bobbycar-graz/Bobbycar-FOC-hardware/README.md

# Bobbycar-FOC-hardware
Our own dual BLDC Motorcontroller

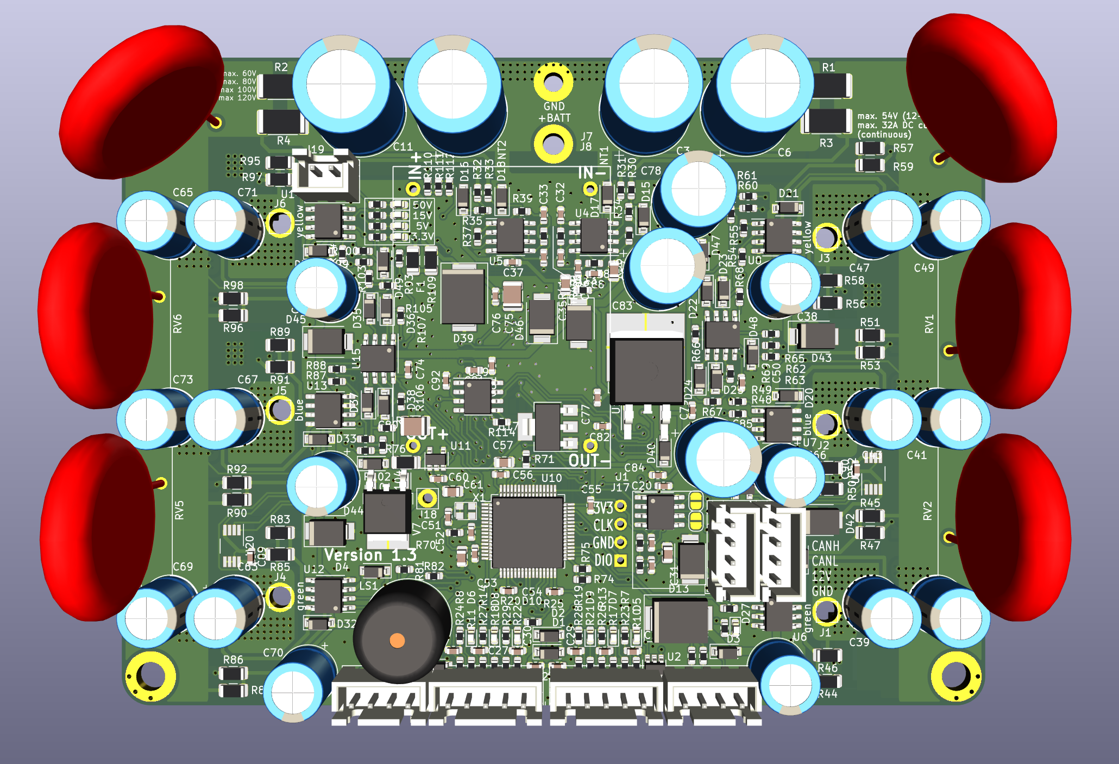
[picture p1: images/3d.png]
