bobbycar-graz/Bobbycar-FOC-hardware/(threads)

Thread 2 (2022-01-07):

Is this PCB fully compatible?

abrarakram19, 2022-01-07:
Is this board design final version compatible with latest firmware version? Or there are any changes? And what is usage of CAN interface implemented in hardware?
And have anyone assembled this PCB? Is it working perfectly or have some issues?
I want to make some modifications on this pcb layout, is there any suggestions for me to address any noticed problem on this layout?
And many thanks for everyone who made this hardware and firmware available as open source.

Thread 5 (2022-04-08):

Clamping diodes on phase current opamp inputs

mickdermack, 2022-04-08:
In the LTspice model I received from Peter, there is an additional clamping diode D4 on the + input of the opamp, which is not present in the KiCAD schematic.

@dschiedsch: Should it be added to the schematic, or is there a reason it was omitted?

Thread 7 (2022-08-09):

Implement 4 motor controller

CommanderRedYT, 2022-08-09:
New pcb layout with lay-down mounted JST, MR30 and XT90.
- http://www.china-amass.com/product/contain/15J45228797MUA28
- http://www.china-amass.com/product/contain/p154529i6gv89Dm1

Single pcb, 2 stm / gd
Single TWAI connector for boardcomputer
Power distribution with exposed copper to solder wire to.
Flat design (lay components down), optimize for minimal height

CommanderRedYT, 2022-12-20:
Will not happen

Closed 2022-12-20.
