bobbycar-graz/Bobbycar-FOC-hardware/pdf/Bobbycontroller.pdf

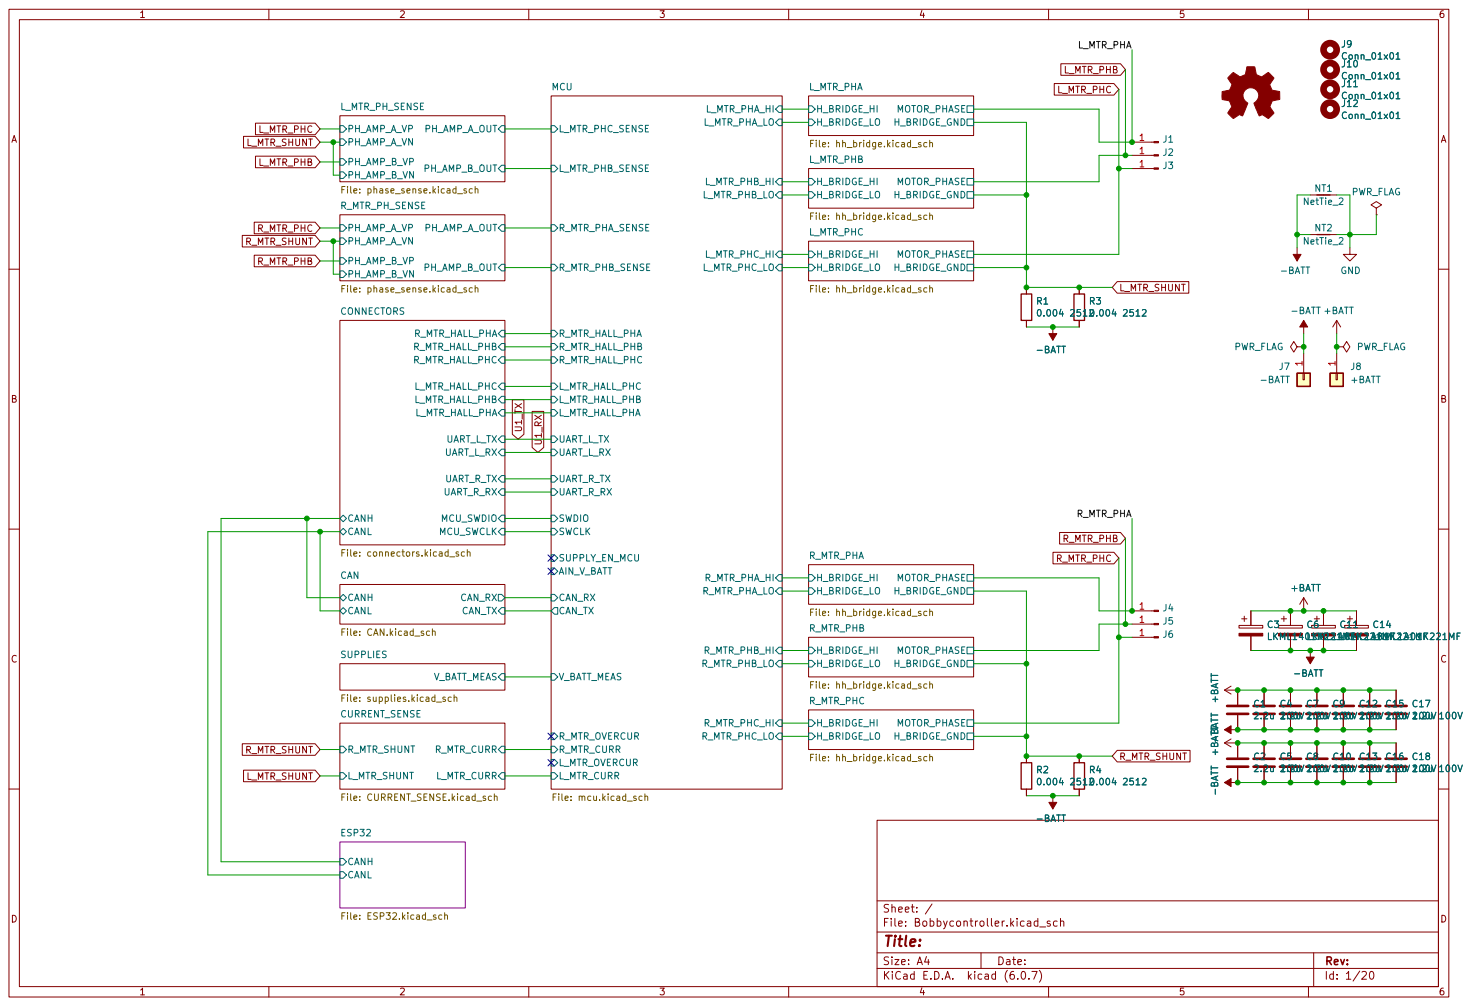
[picture p2: page 1]

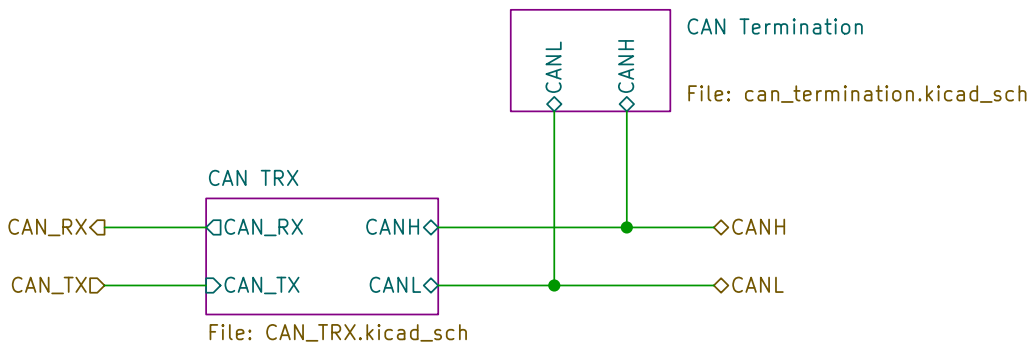
[picture p3: page 2]

CAN Termination File: can_termination.kicad_sch CANH

File: CAN.kicad_sch Sheet: /CAN/
Id: 2/20 Title:

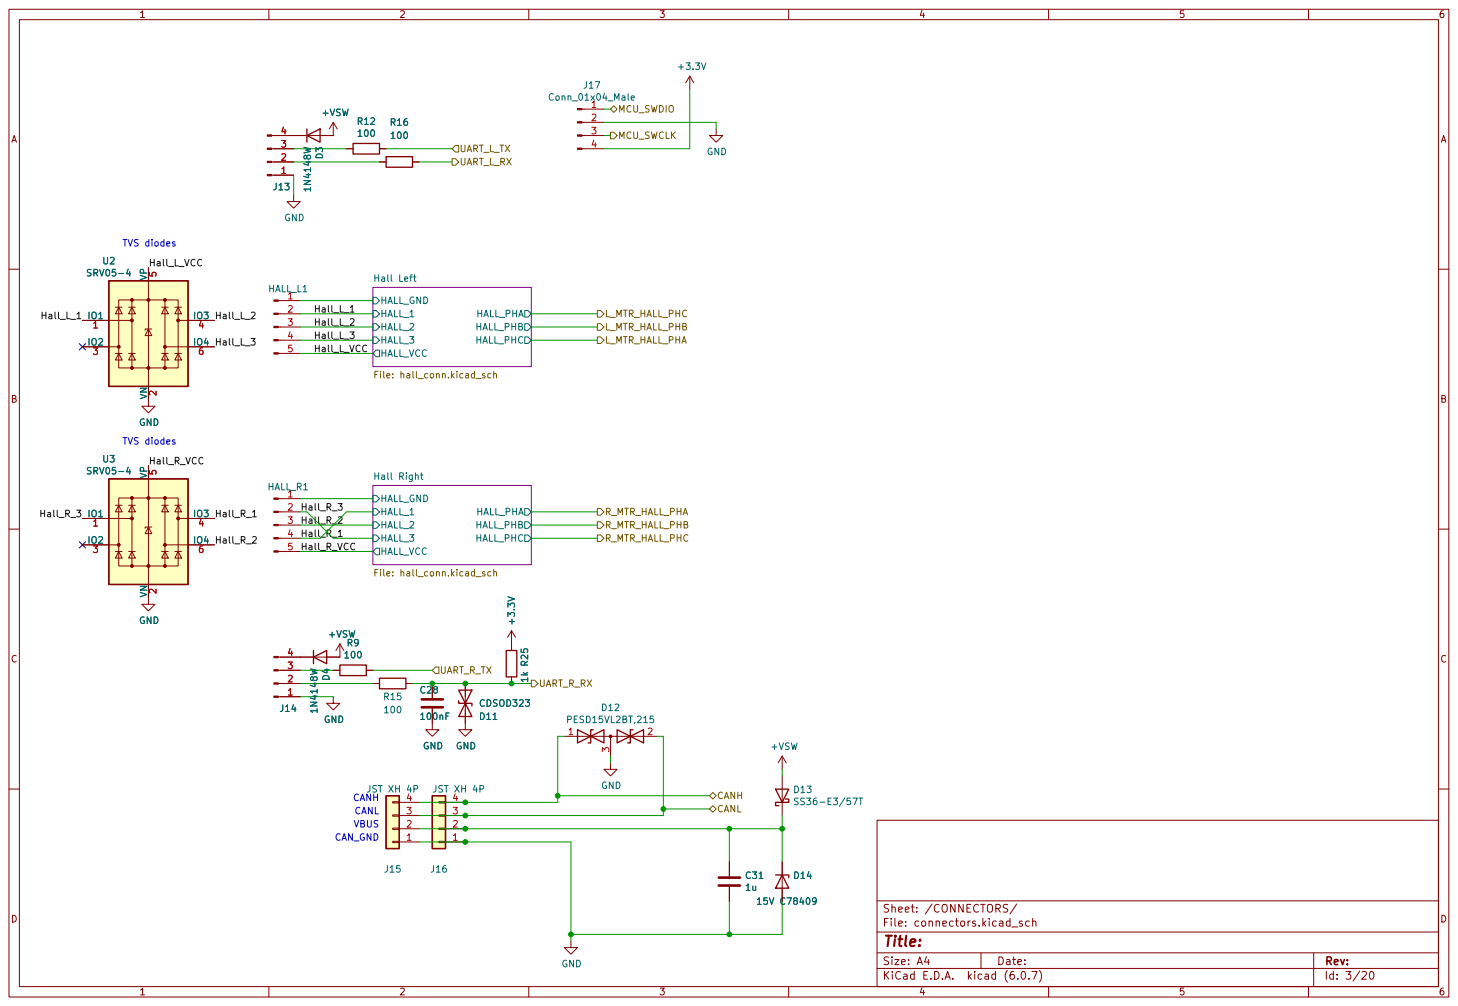
[picture p4: page 3]

File: connectors.kicad_sch Sheet: /CONNECTORS/ HALL_2 HALL_GND
HALL_1 HALL_3 HALL_VCC

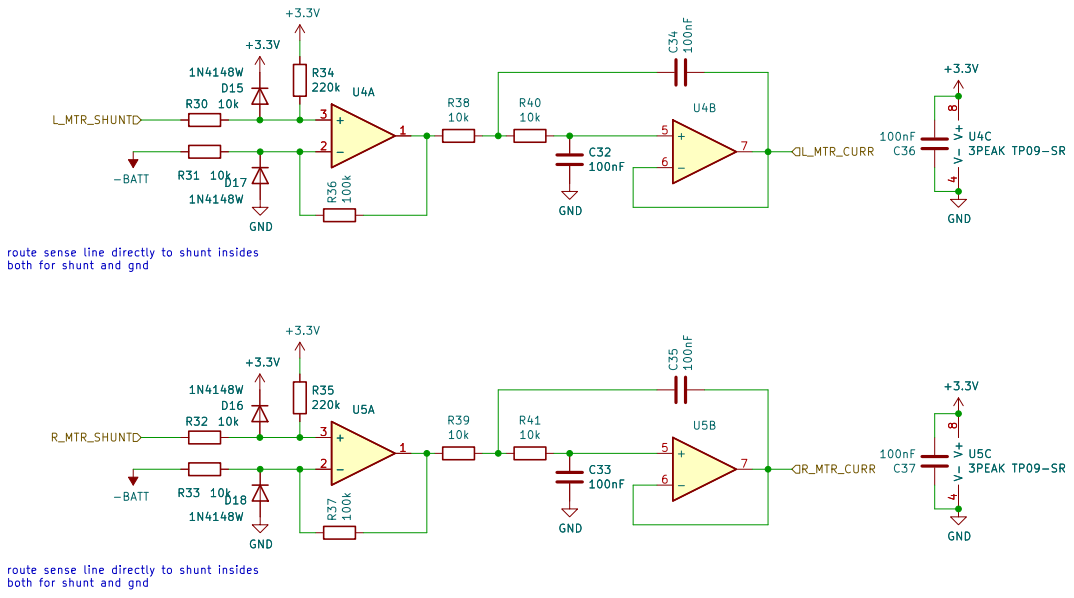
[picture p5: page 4]

route sense line directly to shunt insides

both for shunt and gnd

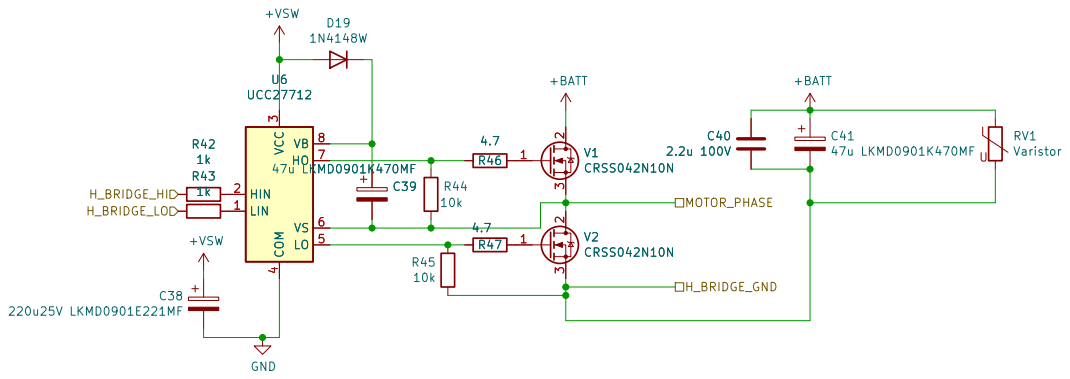
[picture p6: page 5]

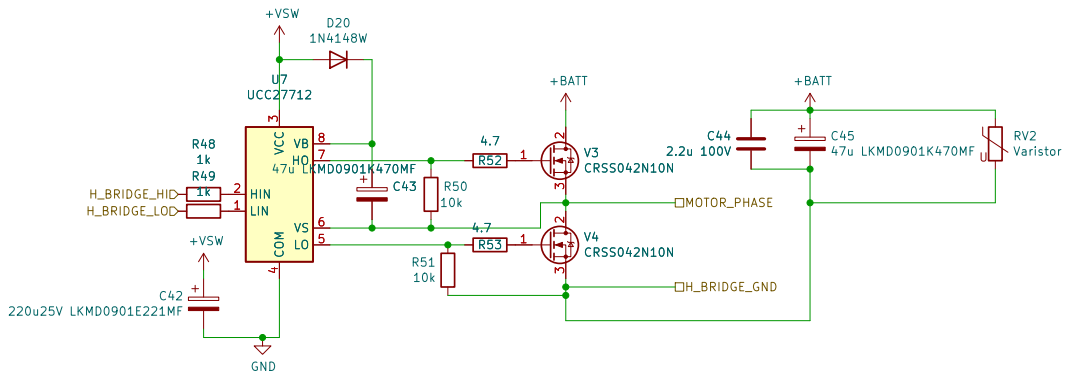
[picture p7: page 6]

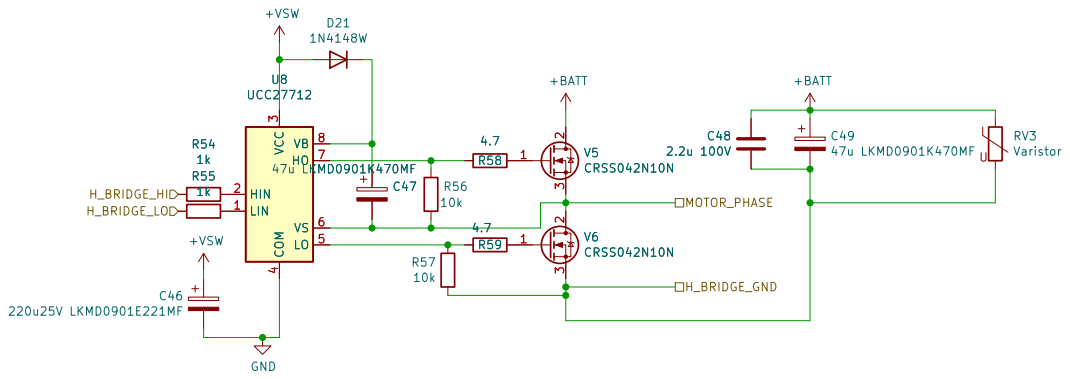
[picture p8: page 7]

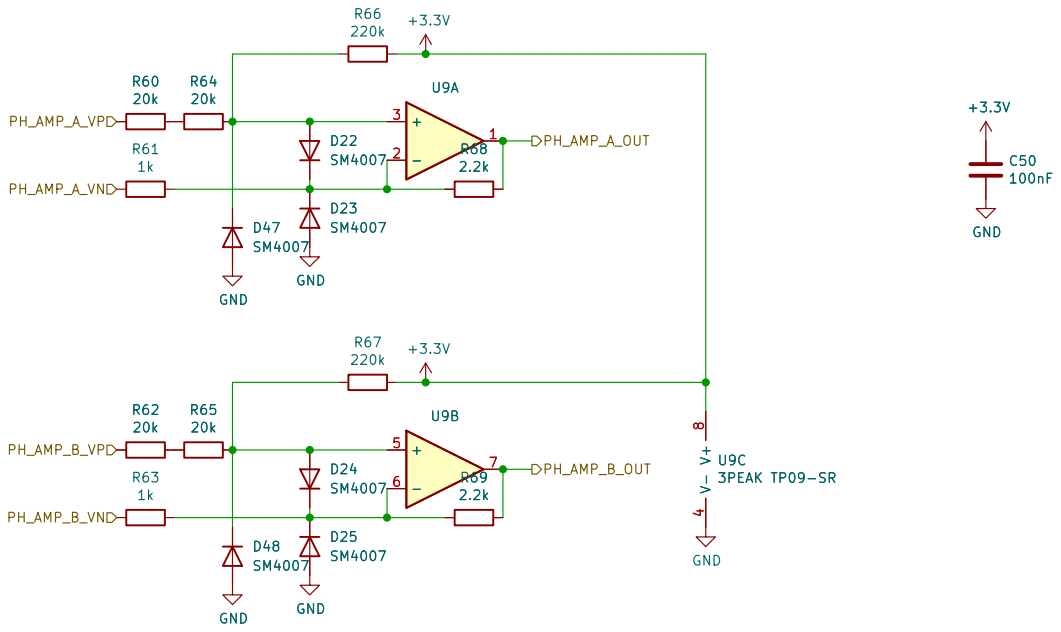
[picture p9: page 8]

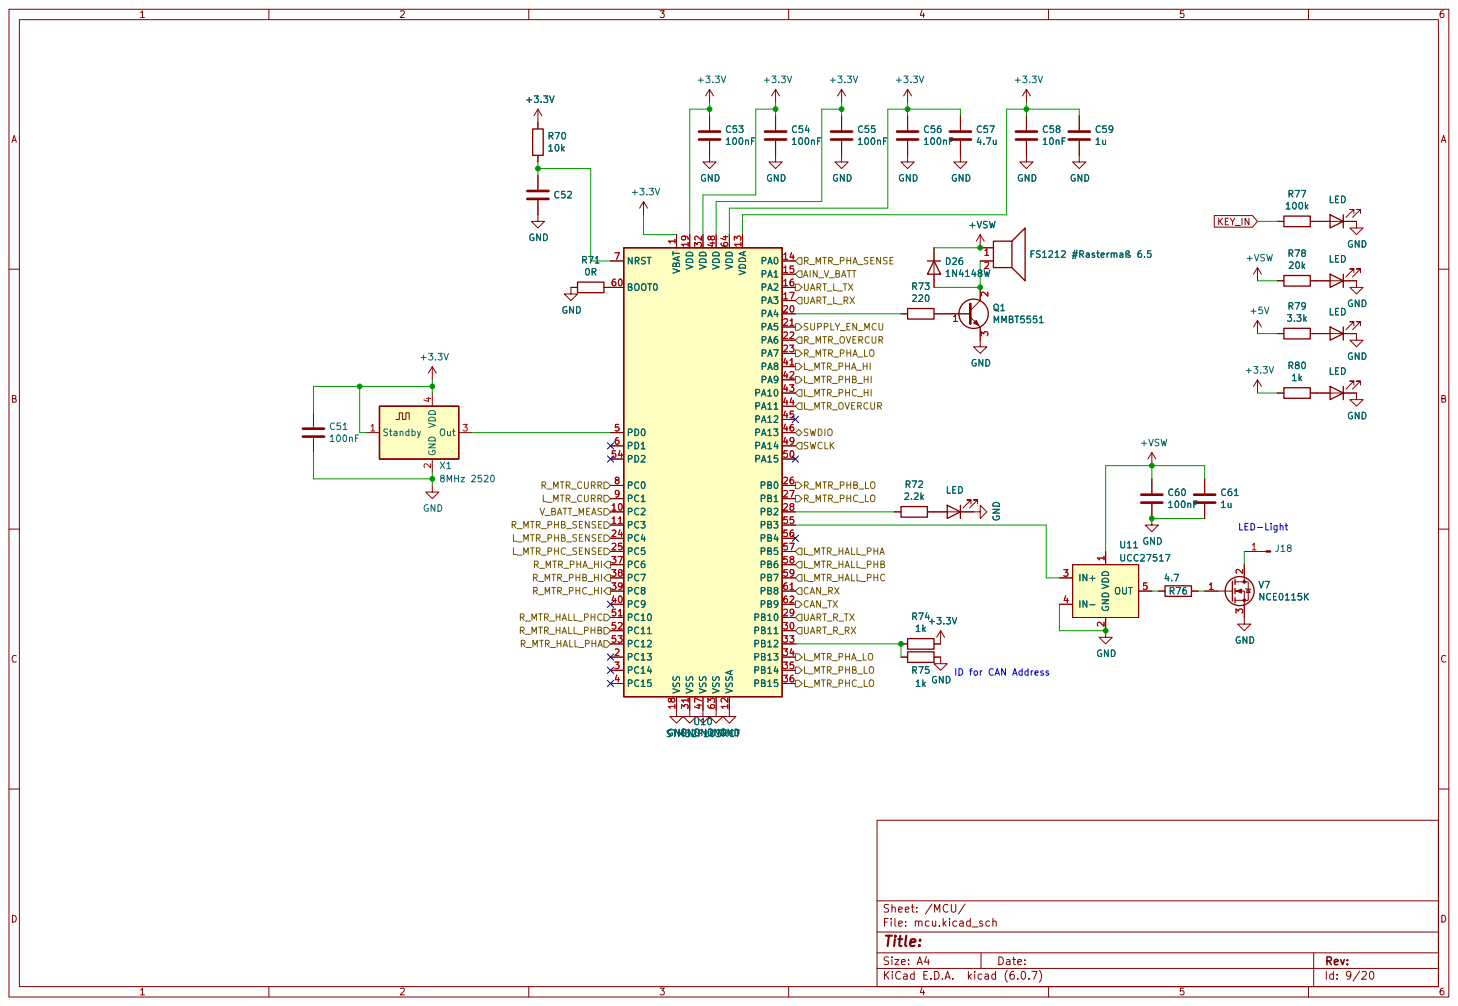
[picture p10: page 9]

1 PC2 10 PC3 11 VSSA 12 VDDA 13 PA0 14 PA1 15 PA2 16 PA3 17 VSS 18 VDD 19 PC13 2 PA4 20 PA5 21 PA6 22 PA7 23 PC4 24 PC5 25 PB0 26 PB1 27 PB2 28 PB10 29 PC14 3 PB11 30 VSS 31 VDD 32 PB12 33 PB13 34 PB14 35 PB15 36 PC6 37 PC7 38 PC8 39 PC15 4 PC9 40 PA8 41 PA9 42 PA10 43 PA11 44 PA12 45 PA13 46 VSS 47 VDD 48 PA14 49 PD0 5 PA15 50 PC10 51 PC11 52 PC12 53 PD2 54 PB3 55 PB4 56 PB5 57 PB6 58 PB7 59 PD1 6 BOOT0 60 PB8 61 PB9 62 VSS 63 VDD 64 NRST 7 PC0 8 PC1 9 C54

ID for CAN Address GND GND

1 PC2 10 PC3 11 VSSA 12 VDDA 13 PA0 14 PA1 15 PA2 16 PA3 17 VSS 18 VDD 19 PC13 2 PA4 20 PA5 21 PA6 22 PA7 23 PC4 24 PC5 25 PB0 26 PB1 27 PB2 28 PB10 29 PC14 3 PB11 30 VSS 31 VDD 32 PB12 33 PB13 34 PB14 35 PB15 36 PC6 37 PC7 38 PC8 39 PC15 4 PC9 40 PA8 41 PA9 42 PA10 43 PA11 44 PA12 45 PA13 46 VSS 47 VDD 48 PA14 49 PD0 5 PA15 50 PC10 51 PC11 52 PC12 53 PD2 54 PB3 55 PB4 56 PB5 57 PB6 58 PB7 59 PD1 6 BOOT0 60 PB8 61 PB9 62 VSS 63 VDD 64 NRST 7 PC0 8 PC1 9 U10 GND STM32F103RCT GNDGNDGNDGND

File: mcu.kicad_sch Sheet: /MCU/
Id: 9/20 Title:

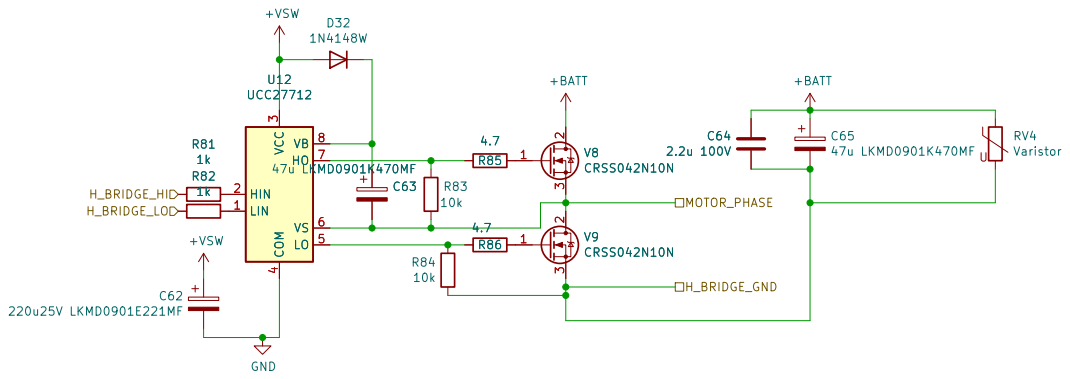
[picture p11: page 10]

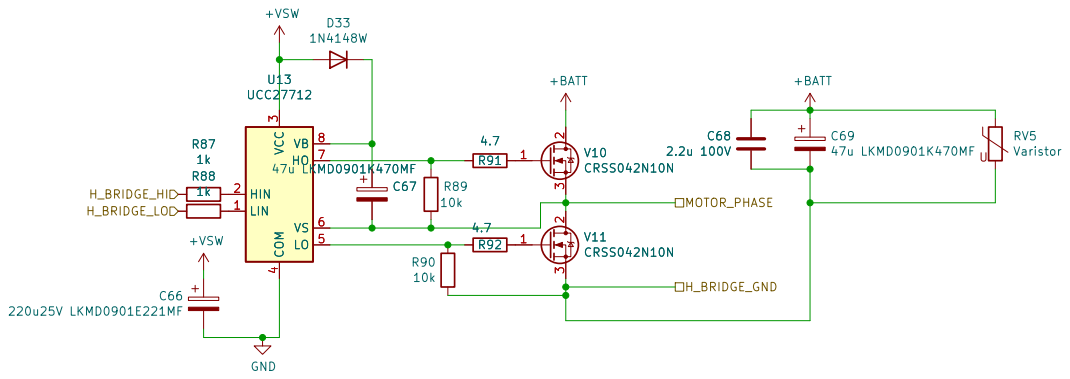
[picture p12: page 11]

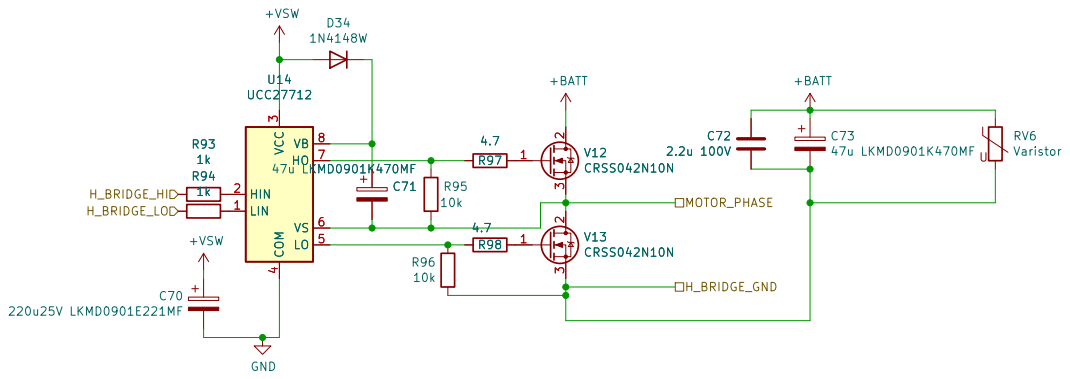
[picture p13: page 12]

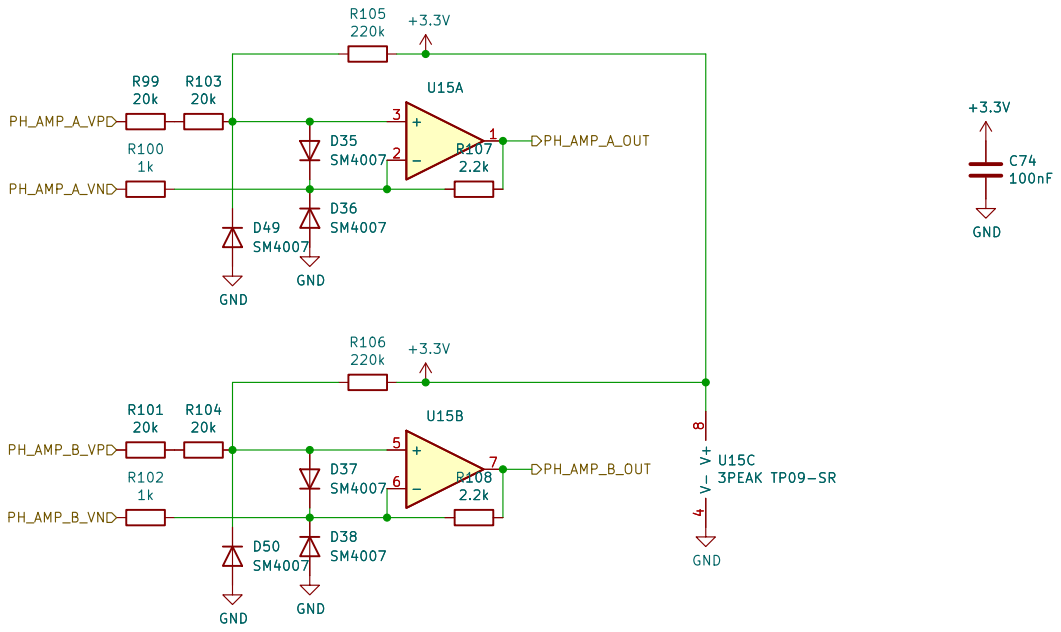
[picture p14: page 13]

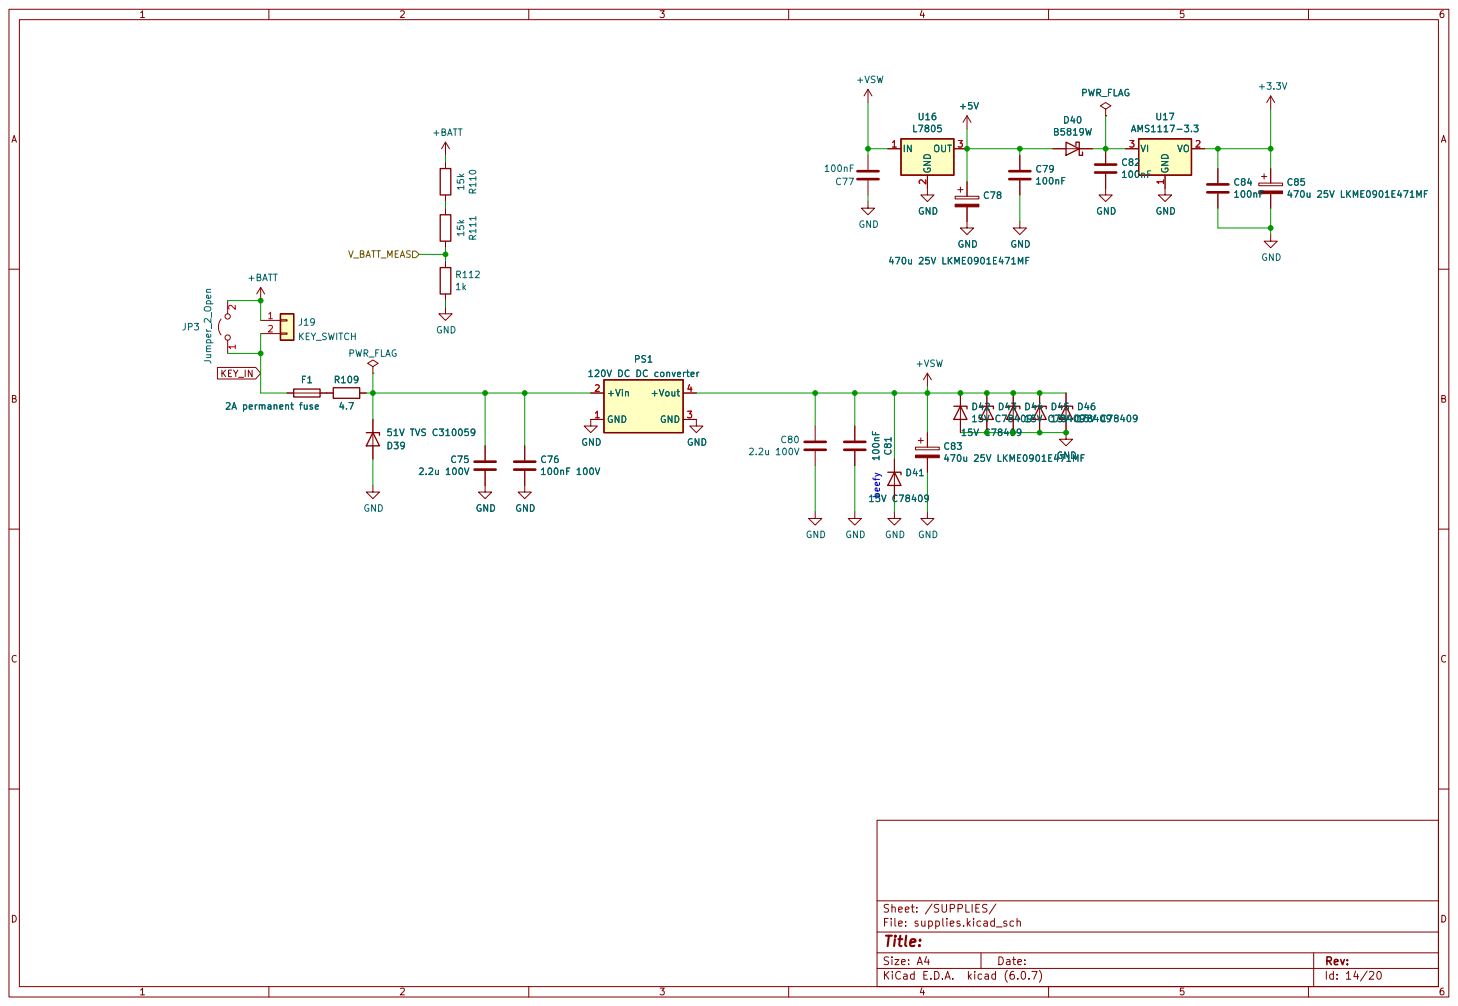
[picture p15: page 14]

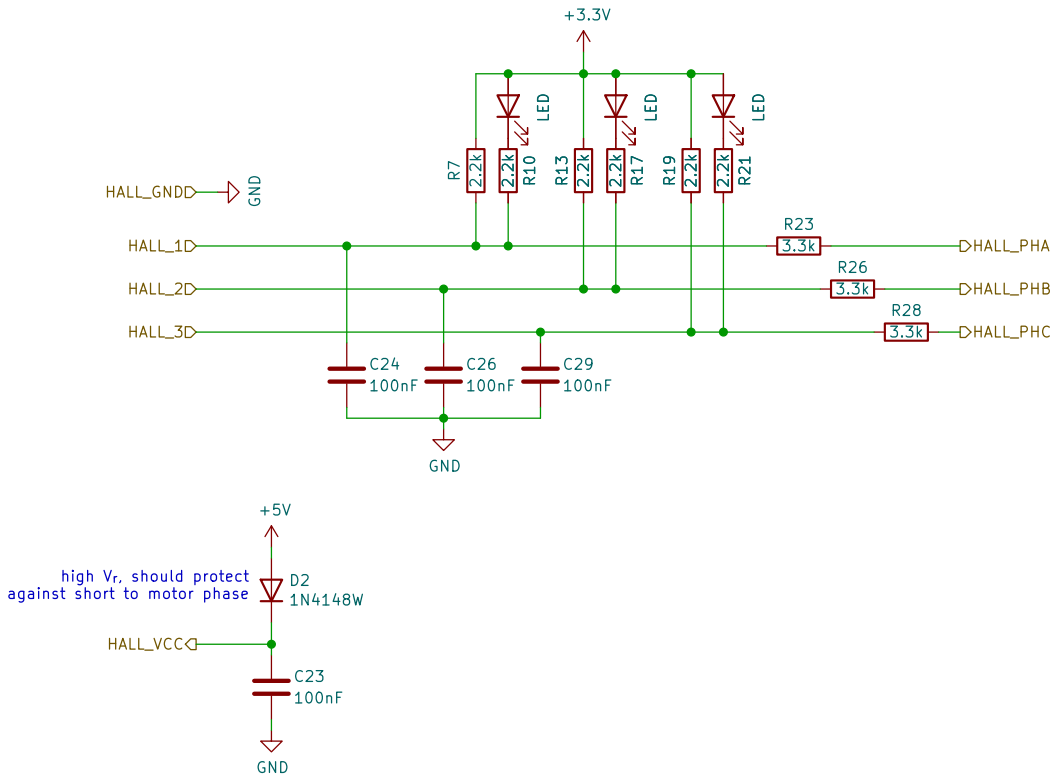
[picture p16: page 15]

File: hall_conn.kicad_sch Sheet: /CONNECTORS/Hall Left/ C24

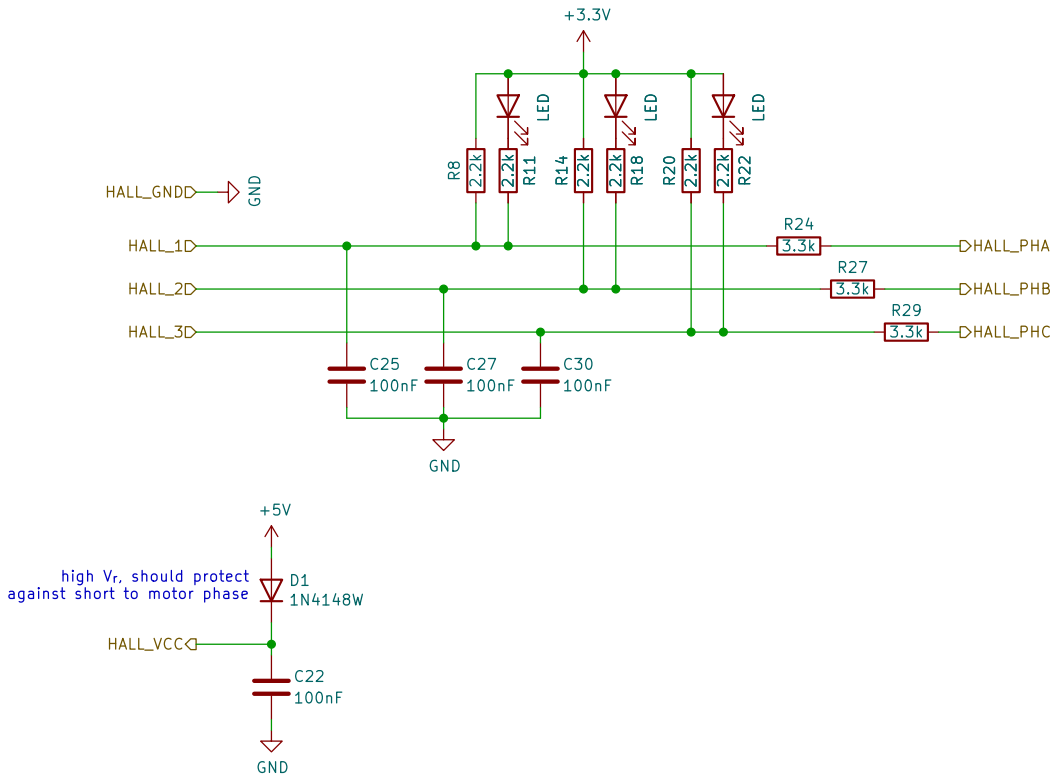
[picture p17: page 16]

Sheet: /CONNECTORS/Hall Right/ C25

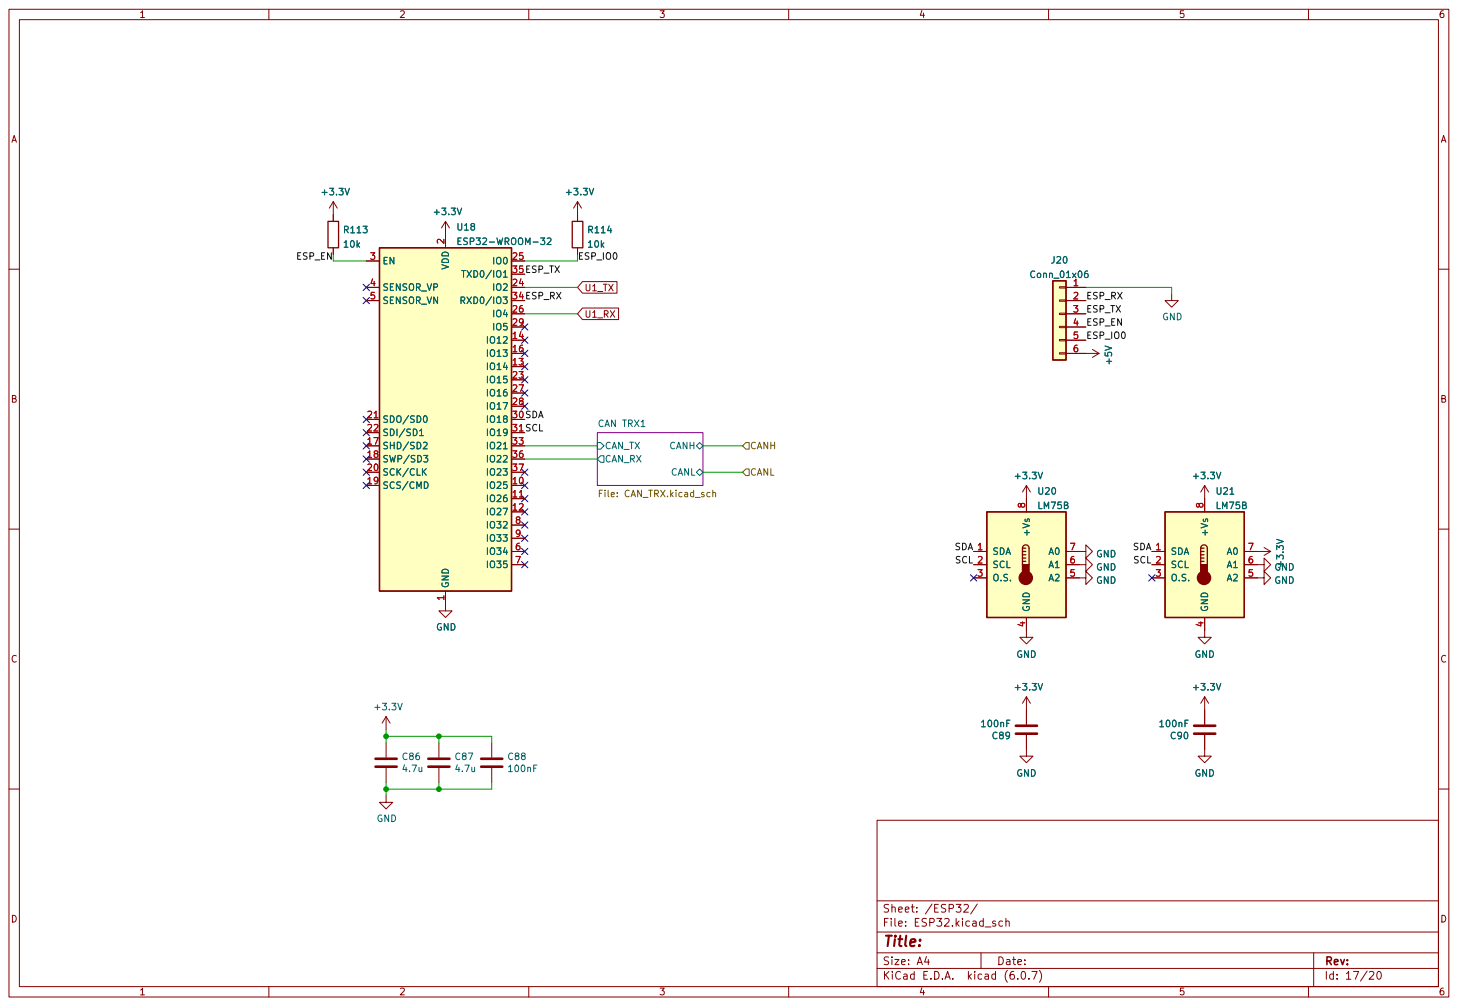
[picture p18: page 17]

2 SCK/CLK 20 SDO/SD0 21 SDI/SD1 22
J20 Conn_01x06 GND

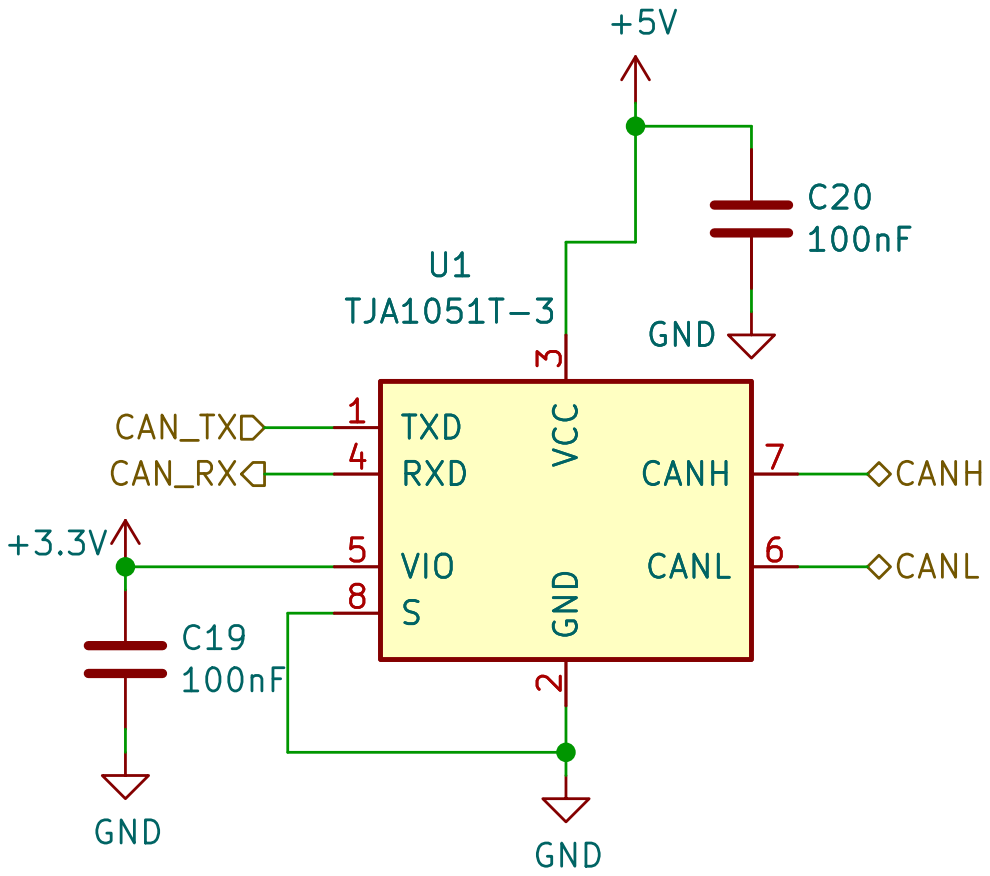
[picture p19: page 18]

3 RXD 4 VIO 5 CANL 6 CANH 7 S

File: CAN_TRX.kicad_sch Sheet: /CAN/CAN TRX/ GND

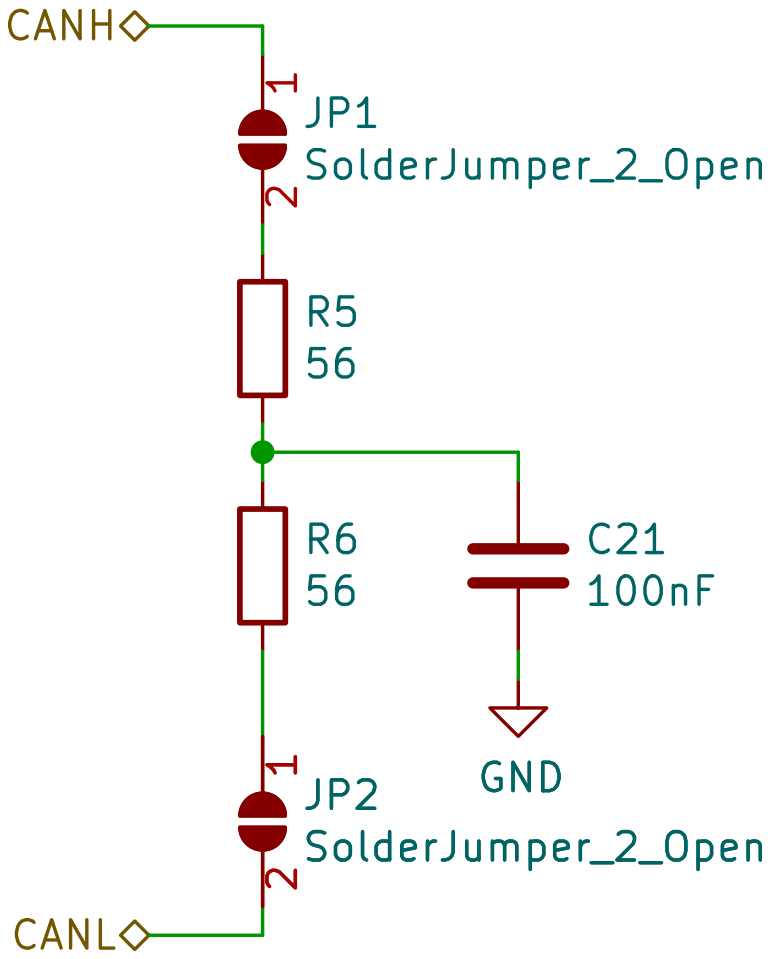
[picture p20: page 19]

File: can_termination.kicad_sch Sheet: /CAN/CAN Termination/
Id: 19/20 Title:

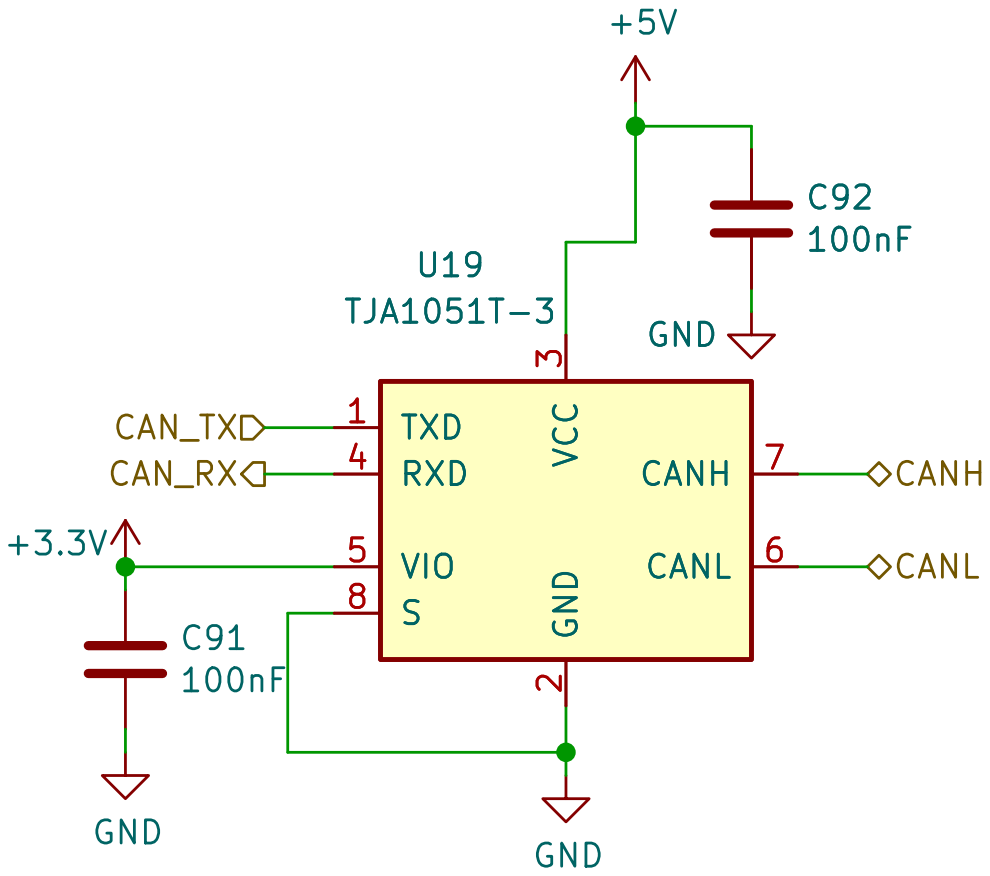
[picture p21: page 20]

3 RXD 4 VIO 5 CANL 6 CANH 7 S

File: CAN_TRX.kicad_sch Sheet: /ESP32/CAN TRX1/ GND
