bobbycar-graz/Bobbycar-FOC-hardware/Bobbycontroller.kicad_pcb

## KiCad design Bobbycontroller.kicad_pcb (continued)

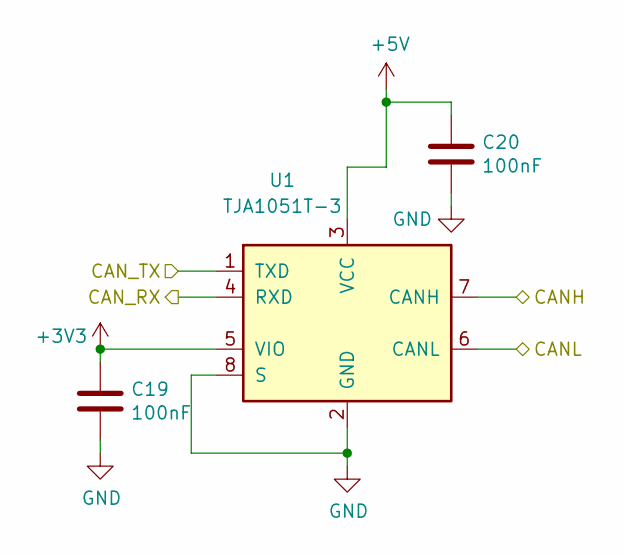
[picture p31: schematic CAN_TRX.kicad_sch]

Parts:
C19, C20: 100nF; C_0603_1608Metric; LCSC C14663
U1: TJA1051T-3; SOIC-8_3.9x4.9mm_P1.27mm; LCSC C38695

Connections:
+3V3: C19.1, U1.5 (VIO); also elsewhere on the board
+5V: C20.1, U1.3 (VCC); also elsewhere on the board
/CAN/CANH: U1.7 (CANH); also elsewhere on the board
/CAN/CANL: U1.6 (CANL); also elsewhere on the board
/CAN/CAN_RX: U1.4 (RXD); also elsewhere on the board
/CAN/CAN_TX: U1.1 (TXD); also elsewhere on the board
GND: C19.2, C20.2, U1.2 (GND), U1.8 (S); also elsewhere on the board

Parts of its further copies:
C91, C92: 100nF; C_0603_1608Metric; LCSC C14663
U19: TJA1051T-3; SOIC-8_3.9x4.9mm_P1.27mm; LCSC C38695

Connections of its further copies:
+3V3: C91.1, U19.5 (VIO); also elsewhere on the board
+5V: C92.1, U19.3 (VCC); also elsewhere on the board
/CAN/CANH: U19.7 (CANH); also elsewhere on the board
/CAN/CANL: U19.6 (CANL); also elsewhere on the board
/ESP32/CAN TRX1/CAN_RX: U19.4 (RXD); also elsewhere on the board
/ESP32/CAN TRX1/CAN_TX: U19.1 (TXD); also elsewhere on the board
GND: C91.2, C92.2, U19.2 (GND), U19.8 (S); also elsewhere on the board

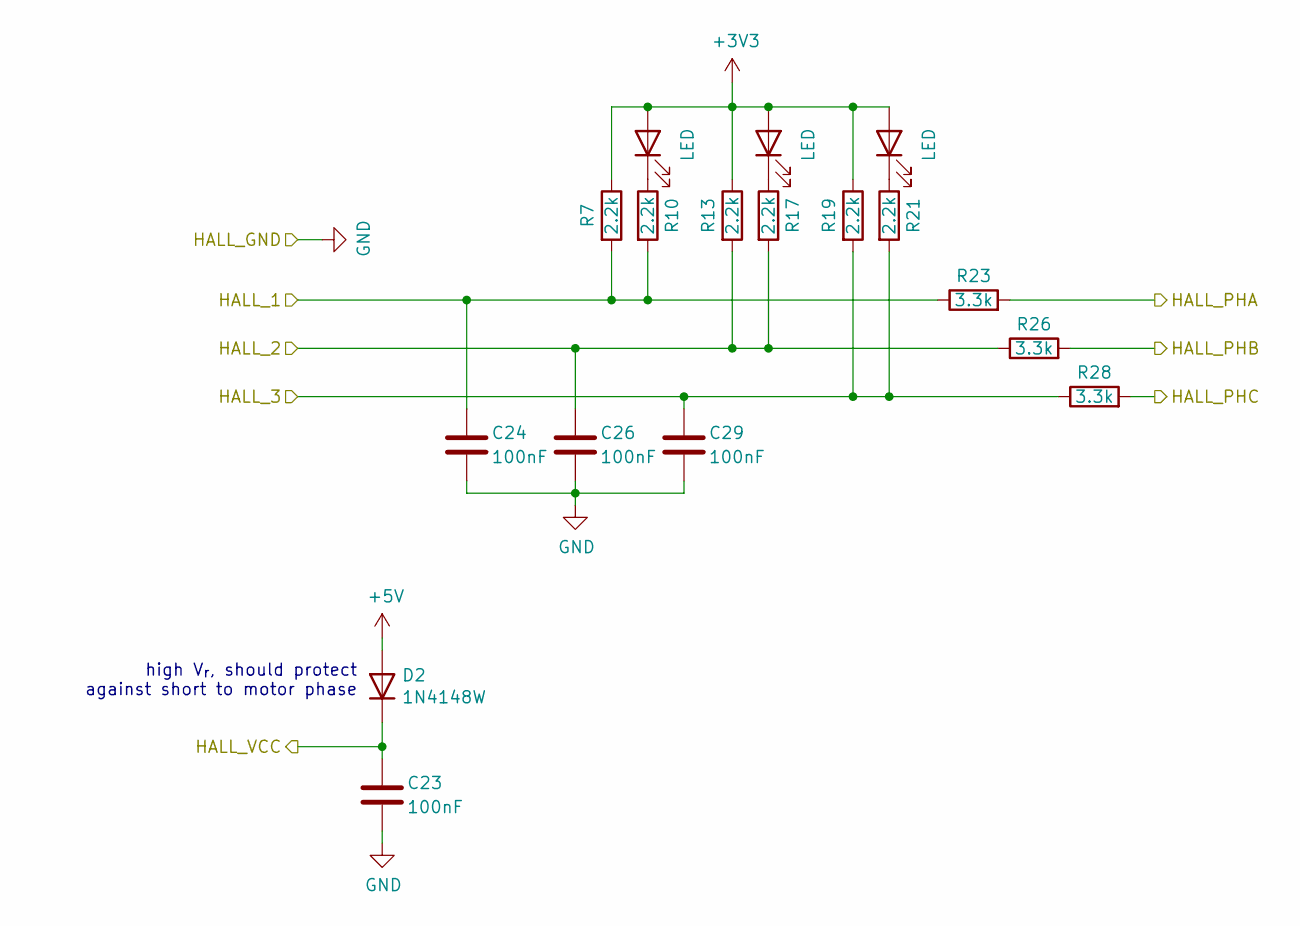
[picture p32: schematic hall_conn.kicad_sch]

Parts:
C23, C24, C26, C29: 100nF; C_0603_1608Metric; LCSC C14663
D2: 1N4148W; D_SOD-123; LCSC C81598
D5, D7, D9: LED; LED_0603_1608Metric; LCSC C2290
R7, R10, R13, R17, R19, R21: 2.2k; R_0603_1608Metric; LCSC C4190
R23, R26, R28: 3.3k; R_0603_1608Metric; LCSC C22978

Connections:
+3V3: D5.2 (A), D7.2 (A), D9.2 (A), R7.1, R13.1, R19.1; also elsewhere on the board
+5V: D2.2 (A); also elsewhere on the board
/CONNECTORS/Hall_L_1: C24.1, R7.2, R10.2, R23.1; also elsewhere on the board
/CONNECTORS/Hall_L_2: C26.1, R13.2, R17.2, R26.1; also elsewhere on the board
/CONNECTORS/Hall_L_3: C29.1, R19.2, R21.2, R28.1; also elsewhere on the board
/CONNECTORS/Hall_L_VCC: C23.1, D2.1 (K); also elsewhere on the board
/CONNECTORS/L_MTR_HALL_PHA: R28.2; also elsewhere on the board
/CONNECTORS/L_MTR_HALL_PHB: R26.2; also elsewhere on the board
/CONNECTORS/L_MTR_HALL_PHC: R23.2; also elsewhere on the board
GND: C23.2, C24.2, C26.2, C29.2; also elsewhere on the board
unnamed: D5.1 (K), R10.1
unnamed: D7.1 (K), R17.1
unnamed: D9.1 (K), R21.1

Parts of its further copies:
C22, C25, C27, C30: 100nF; C_0603_1608Metric; LCSC C14663
D1: 1N4148W; D_SOD-123; LCSC C81598
D6, D8, D10: LED; LED_0603_1608Metric; LCSC C2290
R8, R11, R14, R18, R20, R22: 2.2k; R_0603_1608Metric; LCSC C4190
R24, R27, R29: 3.3k; R_0603_1608Metric; LCSC C22978

Connections of its further copies:
+3V3: D6.2 (A), D8.2 (A), D10.2 (A), R8.1, R14.1, R20.1; also elsewhere on the board
+5V: D1.2 (A); also elsewhere on the board
/CONNECTORS/Hall_R_1: C25.1, R8.2, R11.2, R24.1; also elsewhere on the board
/CONNECTORS/Hall_R_2: C27.1, R14.2, R18.2, R27.1; also elsewhere on the board
/CONNECTORS/Hall_R_3: C30.1, R20.2, R22.2, R29.1; also elsewhere on the board
/CONNECTORS/Hall_R_VCC: C22.1, D1.1 (K); also elsewhere on the board
/CONNECTORS/R_MTR_HALL_PHA: R24.2; also elsewhere on the board
/CONNECTORS/R_MTR_HALL_PHB: R27.2; also elsewhere on the board
/CONNECTORS/R_MTR_HALL_PHC: R29.2; also elsewhere on the board
GND: C22.2, C25.2, C27.2, C30.2; also elsewhere on the board
unnamed: D6.1 (K), R11.1
unnamed: D8.1 (K), R18.1
unnamed: D10.1 (K), R22.1

Notes on the sheet:
high V_{r}, should protect against short to motor phase

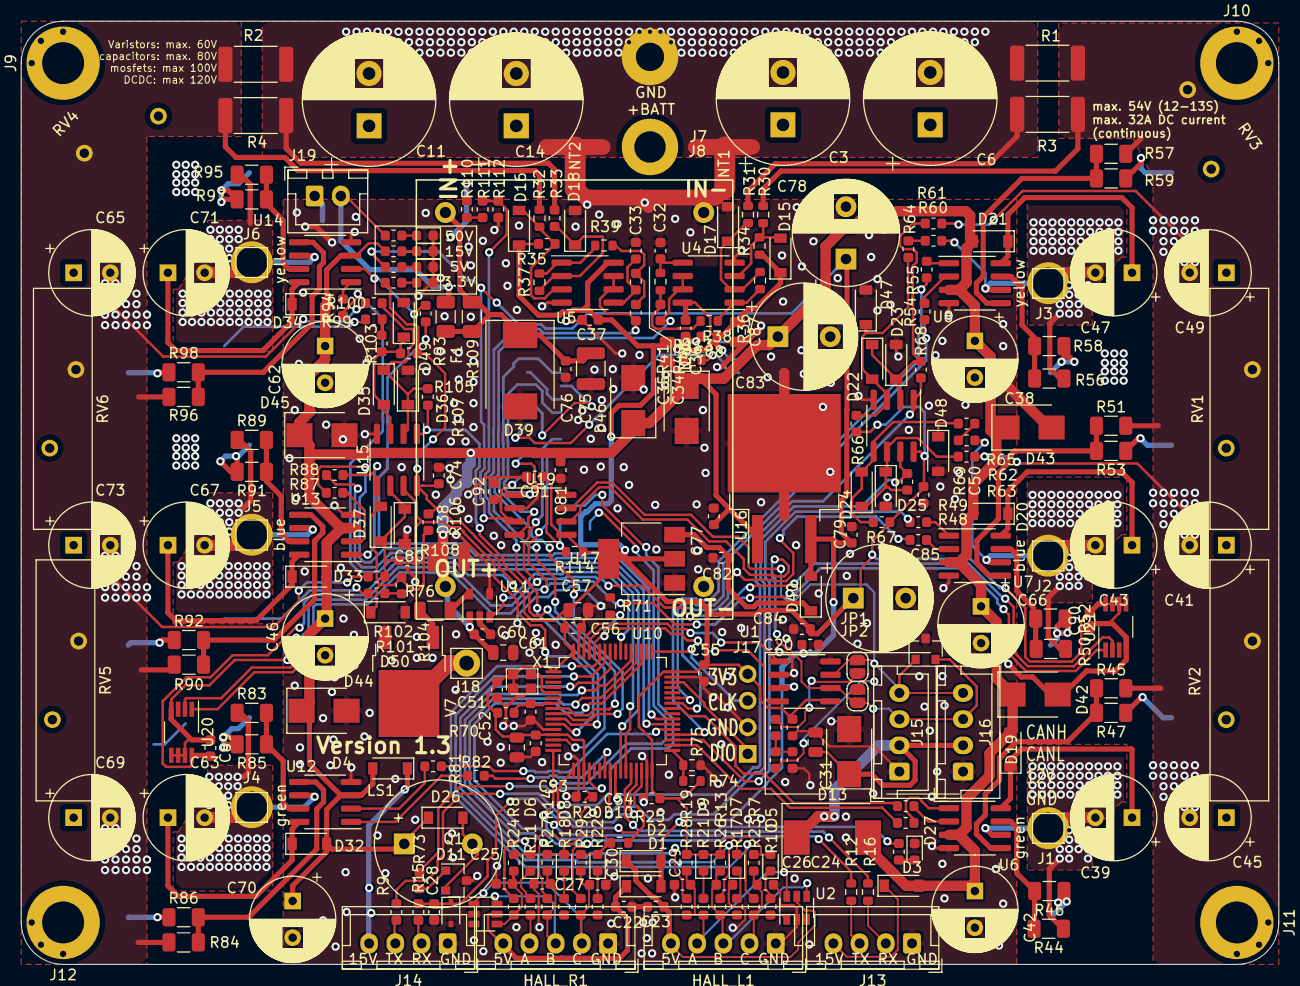
[picture p33: board Bobbycontroller.kicad_pcb from above]

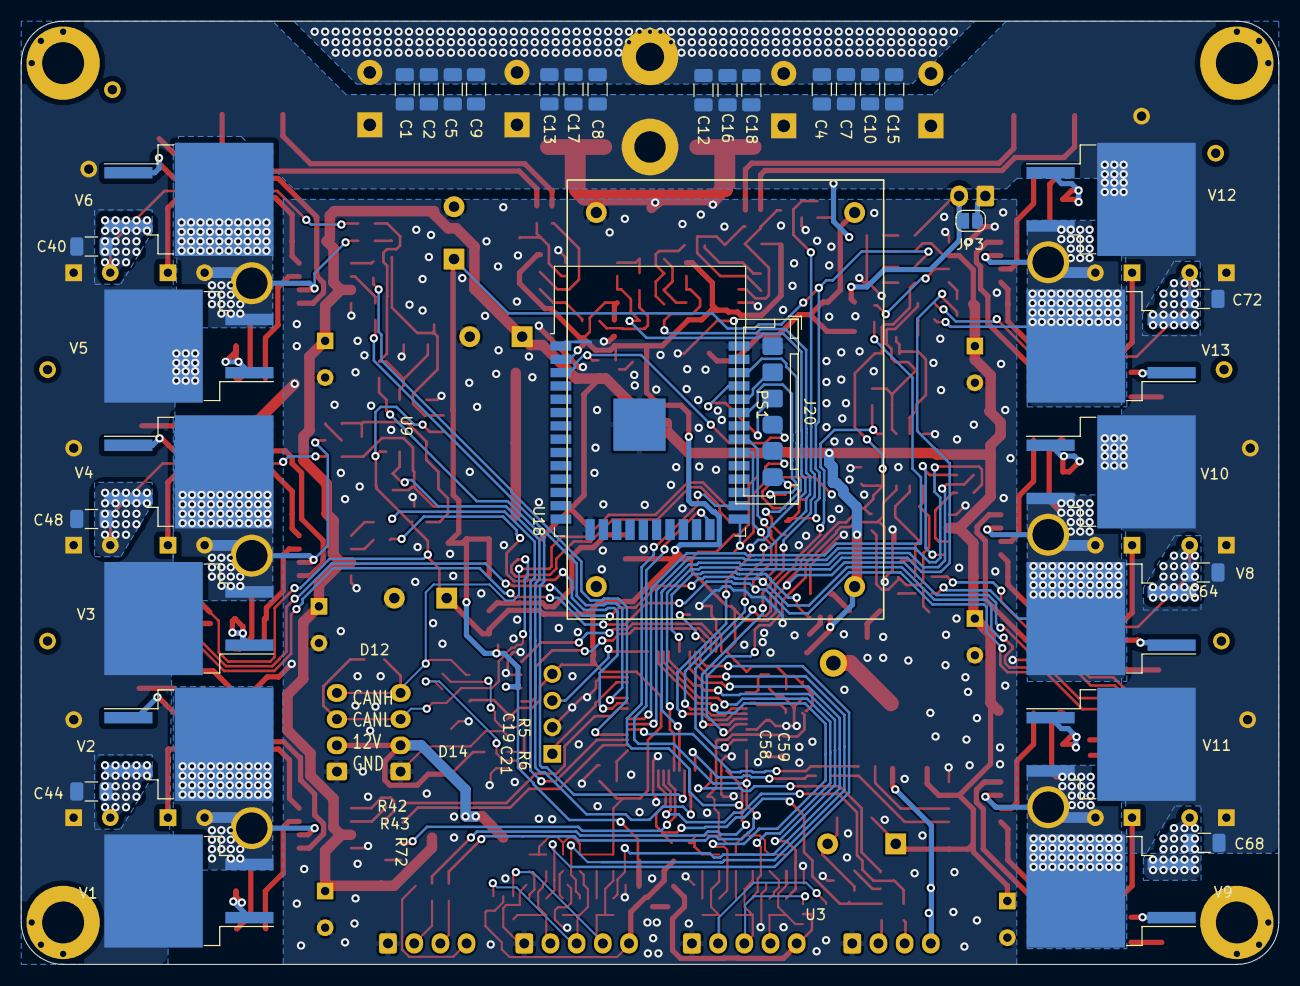
[picture p34: board Bobbycontroller.kicad_pcb from below]

Board: 2 copper layers, 120.0 x 90.0 mm, 328 parts (36 on the bottom side), 166 nets.
