bobbycar-graz/Bobbycar-FOC-hardware/(commit log)

2020-09-27 Fix MCU NRST connection
    [mcu.sch]
2020-09-27 fix some errors
    [Bobbycontroller.sch, CURRENT_SENSE.sch, mcu.sch]
2020-09-27 fix all ERC errors
    [Bobbycontroller.sch, connectors.sch]
2020-09-27 Add CAN transceiver
    [Bobbycontroller.sch, CAN.sch, CURRENT_SENSE.sch, connectors.sch, hh_bridge.sch, mcu.sch, phase_sense.sch, supplies.sch]
2020-09-27 Do MCU bypassing according to datasheet; annotate
    [CAN.sch, connectors.sch, mcu.sch]
2020-09-27 Add +3.3V reverse current protection diode; add +3.3V on debug header
    [connectors.sch, supplies.sch]
2020-09-28 Add missing FET driver connection
    [hh_bridge.sch]
2020-09-28 initial board layout
    [Bobbycontroller.kicad_pcb]
2020-09-28 Remove PWR_FLAG from UART header
    [connectors.sch]
2020-09-28 Add TVS diode, fuse to 15 V supply
    [CURRENT_SENSE.sch, supplies.sch]
2020-09-28 added footprints, continue layout
    [Bobbycontroller.kicad_pcb, CAN.sch, connectors.sch, hh_bridge.sch, mcu.sch, supplies.sch]
2020-09-28 continue analog layout
    [Bobbycontroller.kicad_pcb, connectors.sch, hh_bridge.sch, phase_sense.sch]
2020-09-28 continue board layout, placed all components
    [Bobbycontroller.kicad_pcb, CAN.sch, connectors.sch, hh_bridge.sch, phase_sense.sch]
2020-09-28 layout without hall sensor leds
    [Bobbycontroller.kicad_pcb]
2020-09-28 finish design
    [Bobbycontroller.kicad_pcb, Bobbycontroller.sch, connectors.sch, hh_bridge.sch]
2020-09-28 finish layout
    [Bobbycontroller.kicad_pcb, Bobbycontroller.sch, hh_bridge.sch, phase_sense.sch]
2020-09-28 added TVS diodes on HALL inputs
    [Bobbycontroller.kicad_pcb, Bobbycontroller.sch, connectors.sch, hh_bridge.sch, phase_sense.sch, supplies.sch]
2020-09-28 add logos
    [Bobbycontroller.kicad_pcb, connectors.sch]
2020-09-28 minor changes
    [Bobbycontroller.kicad_pcb]
2020-09-29 Minor changes to PCB; convert footprint library to .pretty format, add to project
    [Bobbycontroller.kicad_pcb, Bobbycontroller.sch, connectors.sch, hh_bridge.sch, supplies.sch]
2020-09-29 modify hall sensor VCC so that overvoltage on one hall sensor will not affect the other motor
    [Bobbycontroller.kicad_pcb, connectors.sch]
2020-09-30 change Mosfet Driver to U3115S
    [Bobbycontroller.kicad_pcb, connectors.sch, hh_bridge.sch]
2020-10-02 add silk screen, change diodes at DCDC converters, remove overcurrent detection, add 100nf
    [Bobbycontroller.kicad_pcb, CURRENT_SENSE.sch, connectors.sch, hh_bridge.sch, phase_sense.sch, supplies.sch]
2020-10-02 fix silkscreen component references
    [Bobbycontroller.kicad_pcb]
2020-10-02 fix labels
    [Bobbycontroller.kicad_pcb, hh_bridge.sch, phase_sense.sch, supplies.sch]
2020-10-02 round board corners
    [Bobbycontroller.kicad_pcb]
2020-10-03 added capacitors
    [Bobbycontroller.kicad_pcb, hh_bridge.sch, phase_sense.sch, supplies.sch]
2020-10-04 add resistors on mosfet driver inputs, change board corners, fix labels
    [Bobbycontroller.kicad_pcb, Bobbycontroller.sch, CAN.sch, connectors.sch, hh_bridge.sch, mcu.sch, phase_sense.sch]
2020-10-06 prepare production files
    [Bobbycontroller.kicad_pcb, hh_bridge.sch]
2020-10-06 production files
    [Bobbycontroller-B_Cu.gbr, Bobbycontroller-B_Mask.gbr, Bobbycontroller-B_Paste.gbr, Bobbycontroller-B_SilkS.gbr, Bobbycontroller-Edge_Cuts.gbr, Bobbycontroller-F_Cu.gbr, Bobbycontroller-F_Mask.gbr, Bobbycontroller-F_Paste.gbr]
2020-10-18 fix some bugs of the first revision
    [Bobbycontroller.kicad_pcb, hh_bridge.sch, mcu.sch, supplies.sch]
2020-10-18 Add oscillator for MCU
    [mcu.sch]
2020-10-18 Layout oscillator
    [Bobbycontroller.kicad_pcb, mcu.sch]
2021-02-02 Changed dcdc converter to lm5164
    [hh_bridge.sch, supplies.sch]
2021-02-03 dcdc layout, MOV
    Layout of new dcdc done, MOVs added but not routed
    [Bobbycontroller.kicad_pcb]
2021-02-03 MOVs placed
    [Bobbycontroller.kicad_pcb, hh_bridge.sch]
2021-02-22 Changed fet driver
    [CAN.sch, hh_bridge.sch, mcu.sch, supplies.sch]
2021-02-24 Added FET for LED
    [Bobbycontroller.kicad_pcb, CAN.sch, hh_bridge.sch, mcu.sch]
2021-03-01 Routed FET and jumper
    [Bobbycontroller.kicad_pcb, CAN.sch, hh_bridge.sch, mcu.sch, phase_sense.sch]
2021-03-05 added rs232, layout changes
    [Bobbycontroller.kicad_pcb, Bobbycontroller.sch, connectors.sch, hh_bridge.sch, phase_sense.sch]
2021-03-09 Added LCSC Part # to most components
    [CAN.sch, CURRENT_SENSE.sch, connectors.sch, hh_bridge.sch, mcu.sch, phase_sense.sch, supplies.sch]
2021-03-10 More adaptation to jlcpcb, parts checking
    [Bobbycontroller-B_Cu.gbr, Bobbycontroller-B_Mask.gbr, Bobbycontroller-B_Paste.gbr, Bobbycontroller-B_SilkS.gbr, Bobbycontroller-Edge_Cuts.gbr, Bobbycontroller-F_Cu.gbr, Bobbycontroller-F_Mask.gbr, Bobbycontroller-F_Paste.gbr]
2021-03-11 Added emergency-break connector
    [Bobbycontroller.kicad_pcb, hh_bridge.sch, mcu.sch, phase_sense.sch]
2021-03-12 Changed emergency brake to uart2 connector
    [Bobbycontroller.kicad_pcb, connectors.sch, mcu.sch]
2021-03-12 Updated production files, added step for coil
    [Bobbycontroller-BOM.csv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]
2021-03-14 Changed 3 LCSC part numbers
    [Bobbycontroller-BOM.csv]
2021-03-14 Added pth caps to assembly
    [Bobbycontroller-BOM.csv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]
2022-01-23 new 120V DCDC, add hall sensors
    [Bobbycontroller.kicad_pcb, Bobbycontroller.kicad_sch, CAN.kicad_sch, CURRENT_SENSE.kicad_sch, connectors.kicad_sch, hh_bridge.kicad_sch, mcu.kicad_sch, phase_sense.kicad_sch]
2022-02-03 add 0R resistor on BOOT0 against GND
    [Bobbycontroller.kicad_pcb, Bobbycontroller.kicad_sch, connectors.kicad_sch, hh_bridge.kicad_sch, mcu.kicad_sch, supplies.kicad_sch]
2022-02-15 removed faulty vias and connections
    [Bobbycontroller.kicad_pcb, hh_bridge.kicad_sch, phase_sense.kicad_sch]
2022-02-15 via change
    [Bobbycontroller.kicad_pcb]
2022-02-17 Silkscreen and naming fixes
    [Bobbycontroller.kicad_pcb, Bobbycontroller.kicad_sch, CAN.kicad_sch, CURRENT_SENSE.kicad_sch, connectors.kicad_sch, hh_bridge.kicad_sch, mcu.kicad_sch, phase_sense.kicad_sch]
2022-03-05 Updated Current sense circuit
    [Bobbycontroller.kicad_pcb, Bobbycontroller.kicad_sch, CURRENT_SENSE.kicad_sch, hh_bridge.kicad_sch, mcu.kicad_sch, phase_sense.kicad_sch, supplies.kicad_sch]
2022-04-02 routed new diodes and opamp
    [Bobbycontroller.kicad_pcb, Bobbycontroller.kicad_sch, CURRENT_SENSE.kicad_sch]
2022-05-04 added esp on bottom side
    [Bobbycontroller.kicad_pcb, Bobbycontroller.kicad_sch, CURRENT_SENSE.kicad_sch, connectors.kicad_sch, mcu.kicad_sch, phase_sense.kicad_sch, supplies.kicad_sch]
2022-05-07 Replace CAN VBUS Diode with beefier; misc. routing changes
    [Bobbycontroller.kicad_pcb, Bobbycontroller.kicad_sch]
2022-05-09 Update CAN VBUS diode in schematic
    fixes 4326932b17624209b9845990315cd6ab7ab2b5f4
    [connectors.kicad_sch]
2022-05-09 Remove *.kicad_prl; update .gitignore
2022-05-09 Refactor stuff adjacent to hall sensor pins
    [Bobbycontroller.kicad_pcb, Bobbycontroller.kicad_sch, CURRENT_SENSE.kicad_sch, connectors.kicad_sch, hall_conn.kicad_sch, hh_bridge.kicad_sch, phase_sense.kicad_sch]
2022-05-09 Update a few library symbols
    [Bobbycontroller.kicad_sch, CURRENT_SENSE.kicad_sch, connectors.kicad_sch, hall_conn.kicad_sch, hh_bridge.kicad_sch, mcu.kicad_sch, phase_sense.kicad_sch, supplies.kicad_sch]
2022-05-09 Some ERC fixes and other cleanups
    [Bobbycontroller.kicad_sch, connectors.kicad_sch, hall_conn.kicad_sch, mcu.kicad_sch, supplies.kicad_sch]
2022-05-09 Add some decoupling caps; some more cleanups
    [Bobbycontroller.kicad_pcb, Bobbycontroller.kicad_sch, CAN.kicad_sch, CAN_TRX.kicad_sch, ESP32.kicad_sch, can_termination.kicad_sch, connectors.kicad_sch, hall_conn.kicad_sch]
2022-05-09 Remove files from old KiCAD version
    [Bobbycontroller.sch, CAN.sch, CURRENT_SENSE.sch, connectors.sch, hh_bridge.sch, mcu.sch, phase_sense.sch, supplies.sch]
2022-06-23 ordered this on jlcpcb
    [BOM-Bobbycontroller.csv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]
2025-08-09 Updated diodes, added LCSC numbers for all parts
    [Bobbycontroller.kicad_sch, CAN.kicad_sch, CAN_TRX.kicad_sch, CURRENT_SENSE.kicad_sch, ESP32.kicad_sch, can_termination.kicad_sch, connectors.kicad_sch, hall_conn.kicad_sch]
2025-08-09 update lcsc numbers
    [BOM-Bobbycontroller.csv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]
2025-08-09 Exchanged more components, DNP and bridge 4.7R resistor, DNP 51V TVS diode
    [BOM-Bobbycontroller.csv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]
